Antony76/AllAboutNeowayM590/README.md

# All about Neoway GSM/GPRS modem M590/M590e

This repo started as a "bookmark" to me to bringup this M590 module

 Please start with the Wiki https://github.com/Antony76/AllAboutNeowayM590/wiki

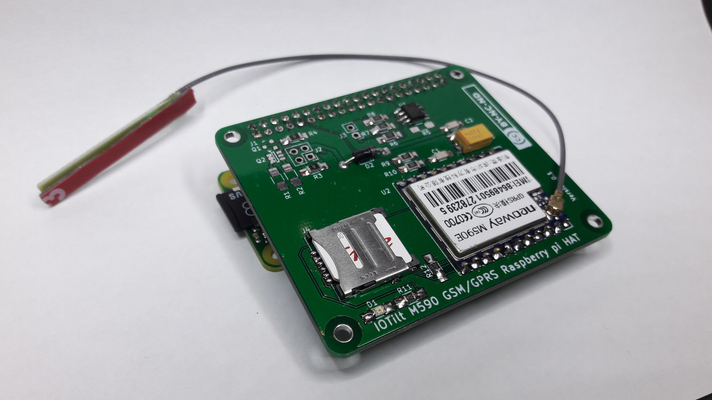
[picture p1: docs/Raspberry_piB+_HAT.jpg]
PCB
