Antony76/AllAboutNeowayM590/datasheet/M590_pinout.jpg

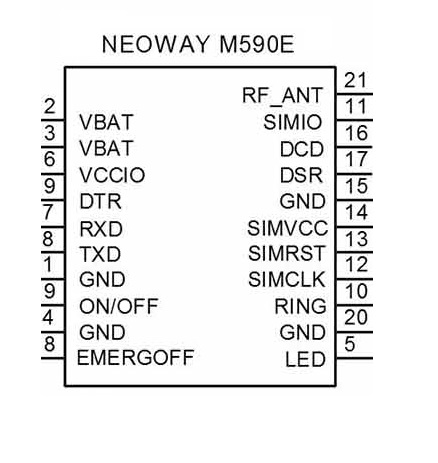
datasheet/M590_pinout.jpg
