Antony76/AllAboutNeowayM590/datasheet/MicroSIMSocket_bottom.jpg

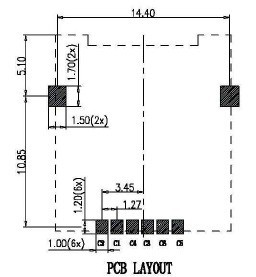
datasheet/MicroSIMSocket_bottom.jpg
