Antony76/AllAboutNeowayM590/datasheet/MicroSIMSocket_top.jpg

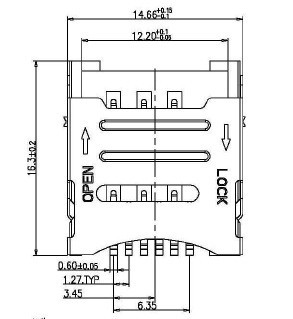
datasheet/MicroSIMSocket_top.jpg
