Antony76/AllAboutNeowayM590/docs/SIMpinout.png

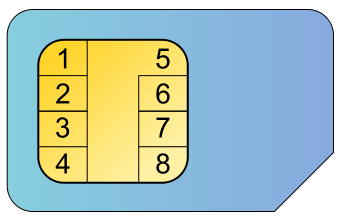
docs/SIMpinout.png
