Antony76/AllAboutNeowayM590/docs/usb-ttl1.jpg

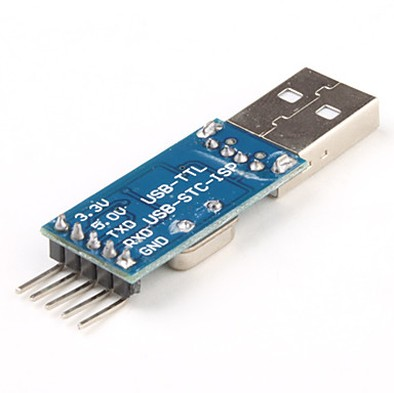
docs/usb-ttl1.jpg
