Antony76/AllAboutNeowayM590/docs/usb-ttl2.jpg

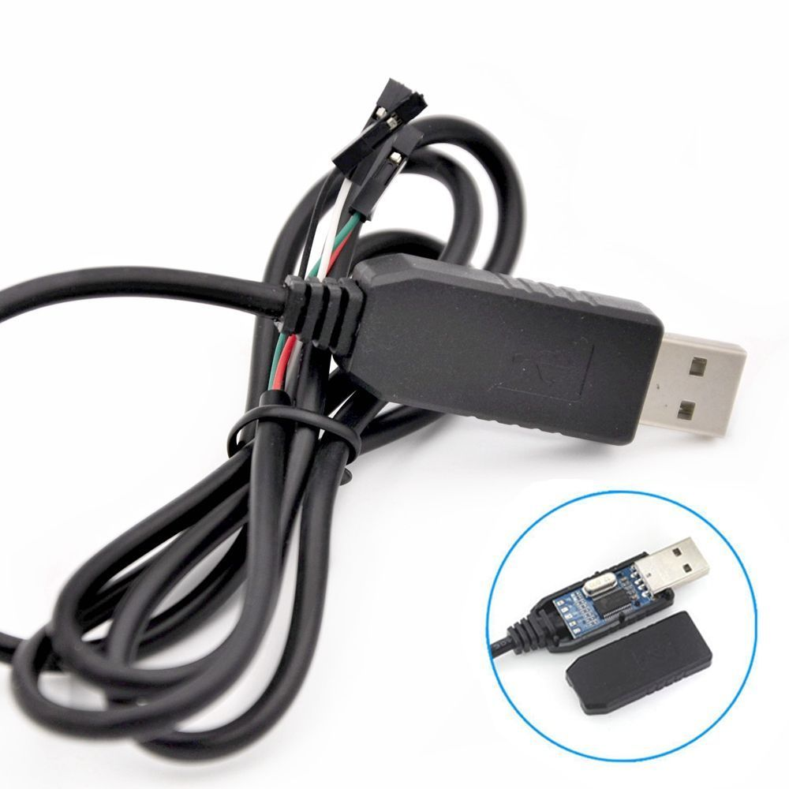
docs/usb-ttl2.jpg
