Antony76/AllAboutNeowayM590/PCB/Neoway_m590_diy_kit.jpg

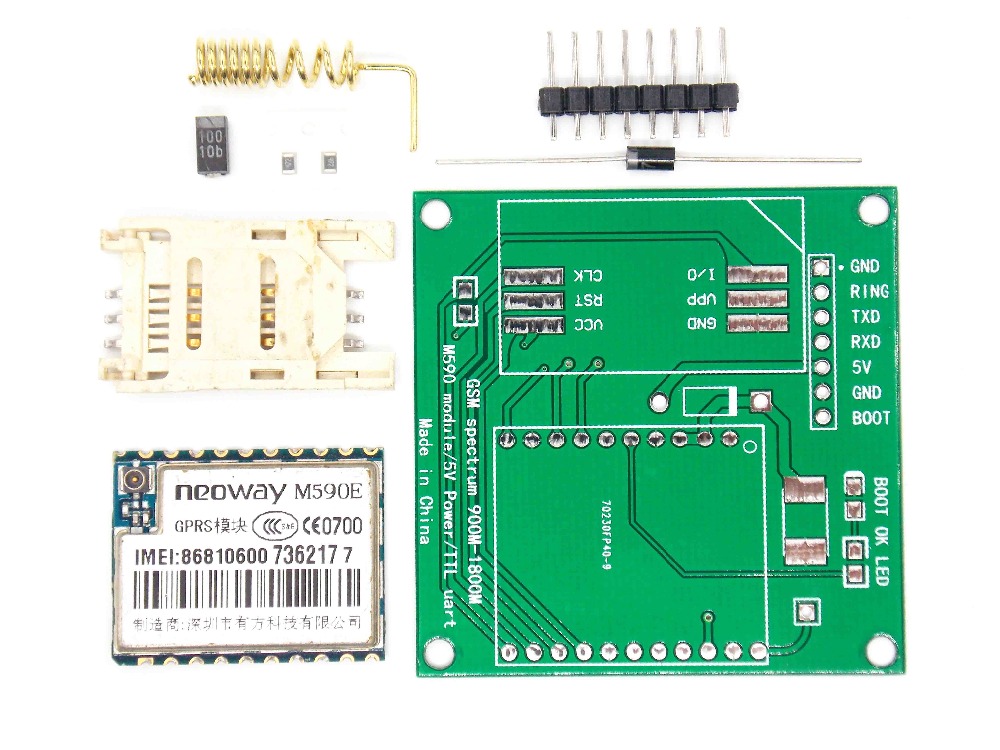
PCB/Neoway_m590_diy_kit.jpg
