Antony76/AllAboutNeowayM590/PCB/pcb_copper_side.jpg

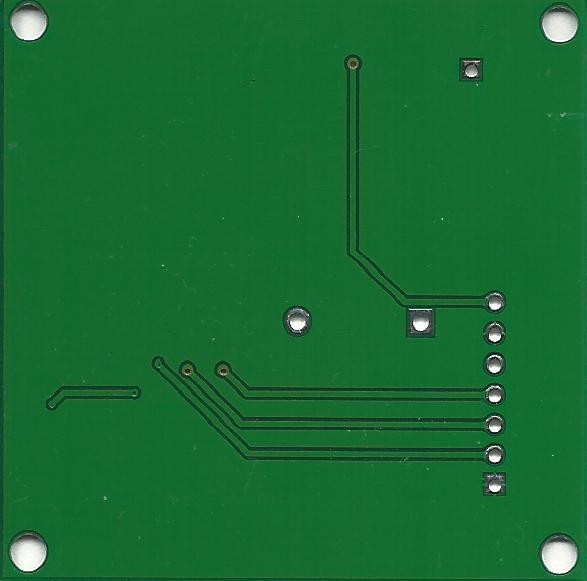
PCB/pcb_copper_side.jpg
