Antony76/AllAboutNeowayM590/PCB/pcb_top_side.jpg

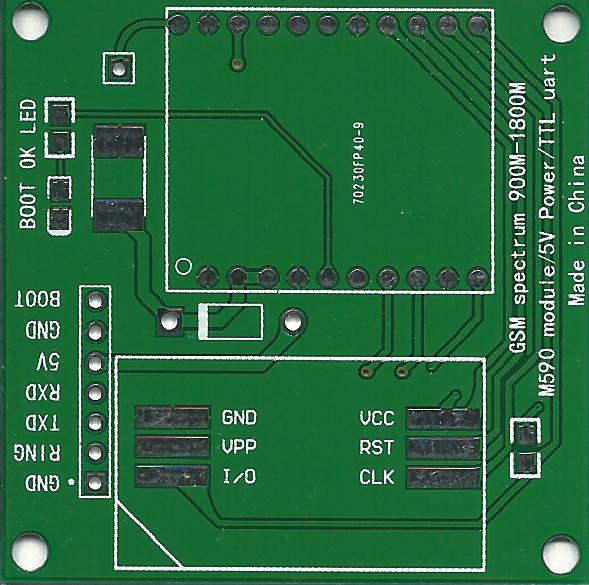
PCB/pcb_top_side.jpg
