Antony76/AllAboutNeowayM590/PCB/raspberrrypi_hat/meta/original_placement.png

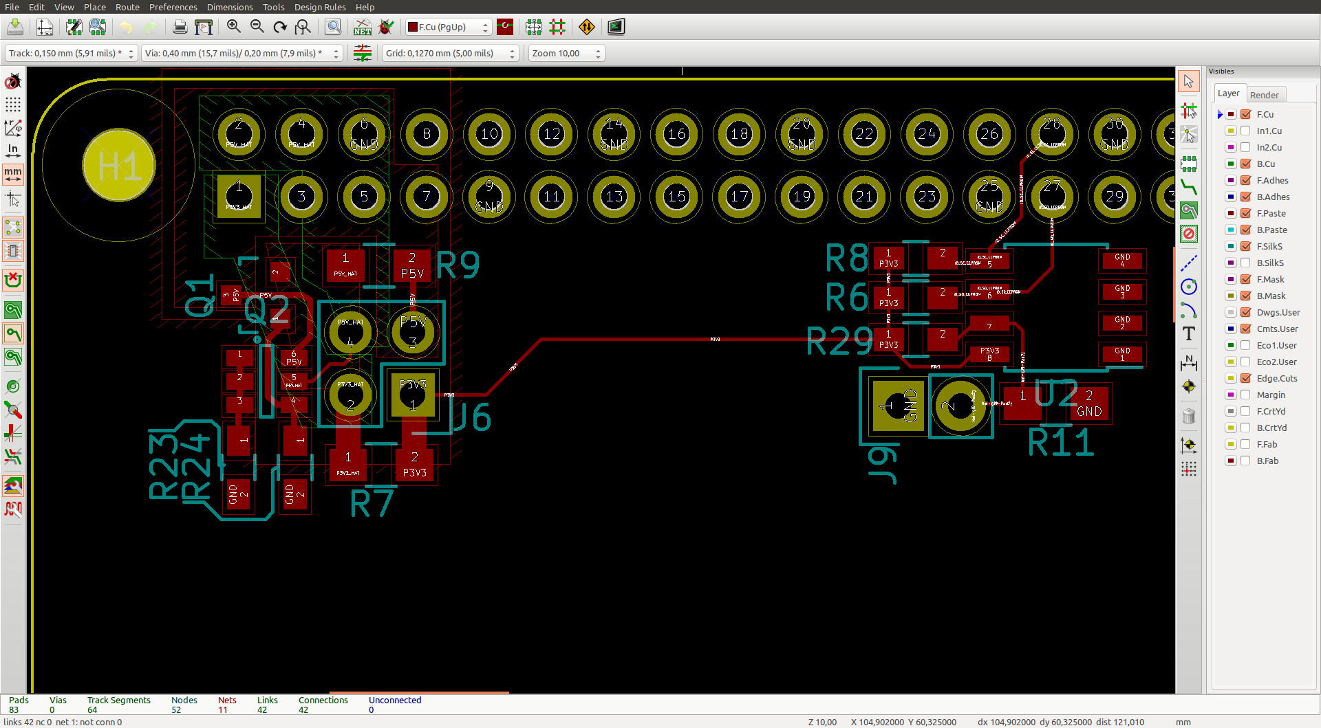
PCB/raspberrrypi_hat/meta/original_placement.png
