Antony76/AllAboutNeowayM590/PCB/raspberrrypi_hat/raspberrrypi_hat.kicad_pcb

## KiCad design PCB/raspberrrypi_hat/raspberrrypi_hat.kicad_pcb (2017-07-28)

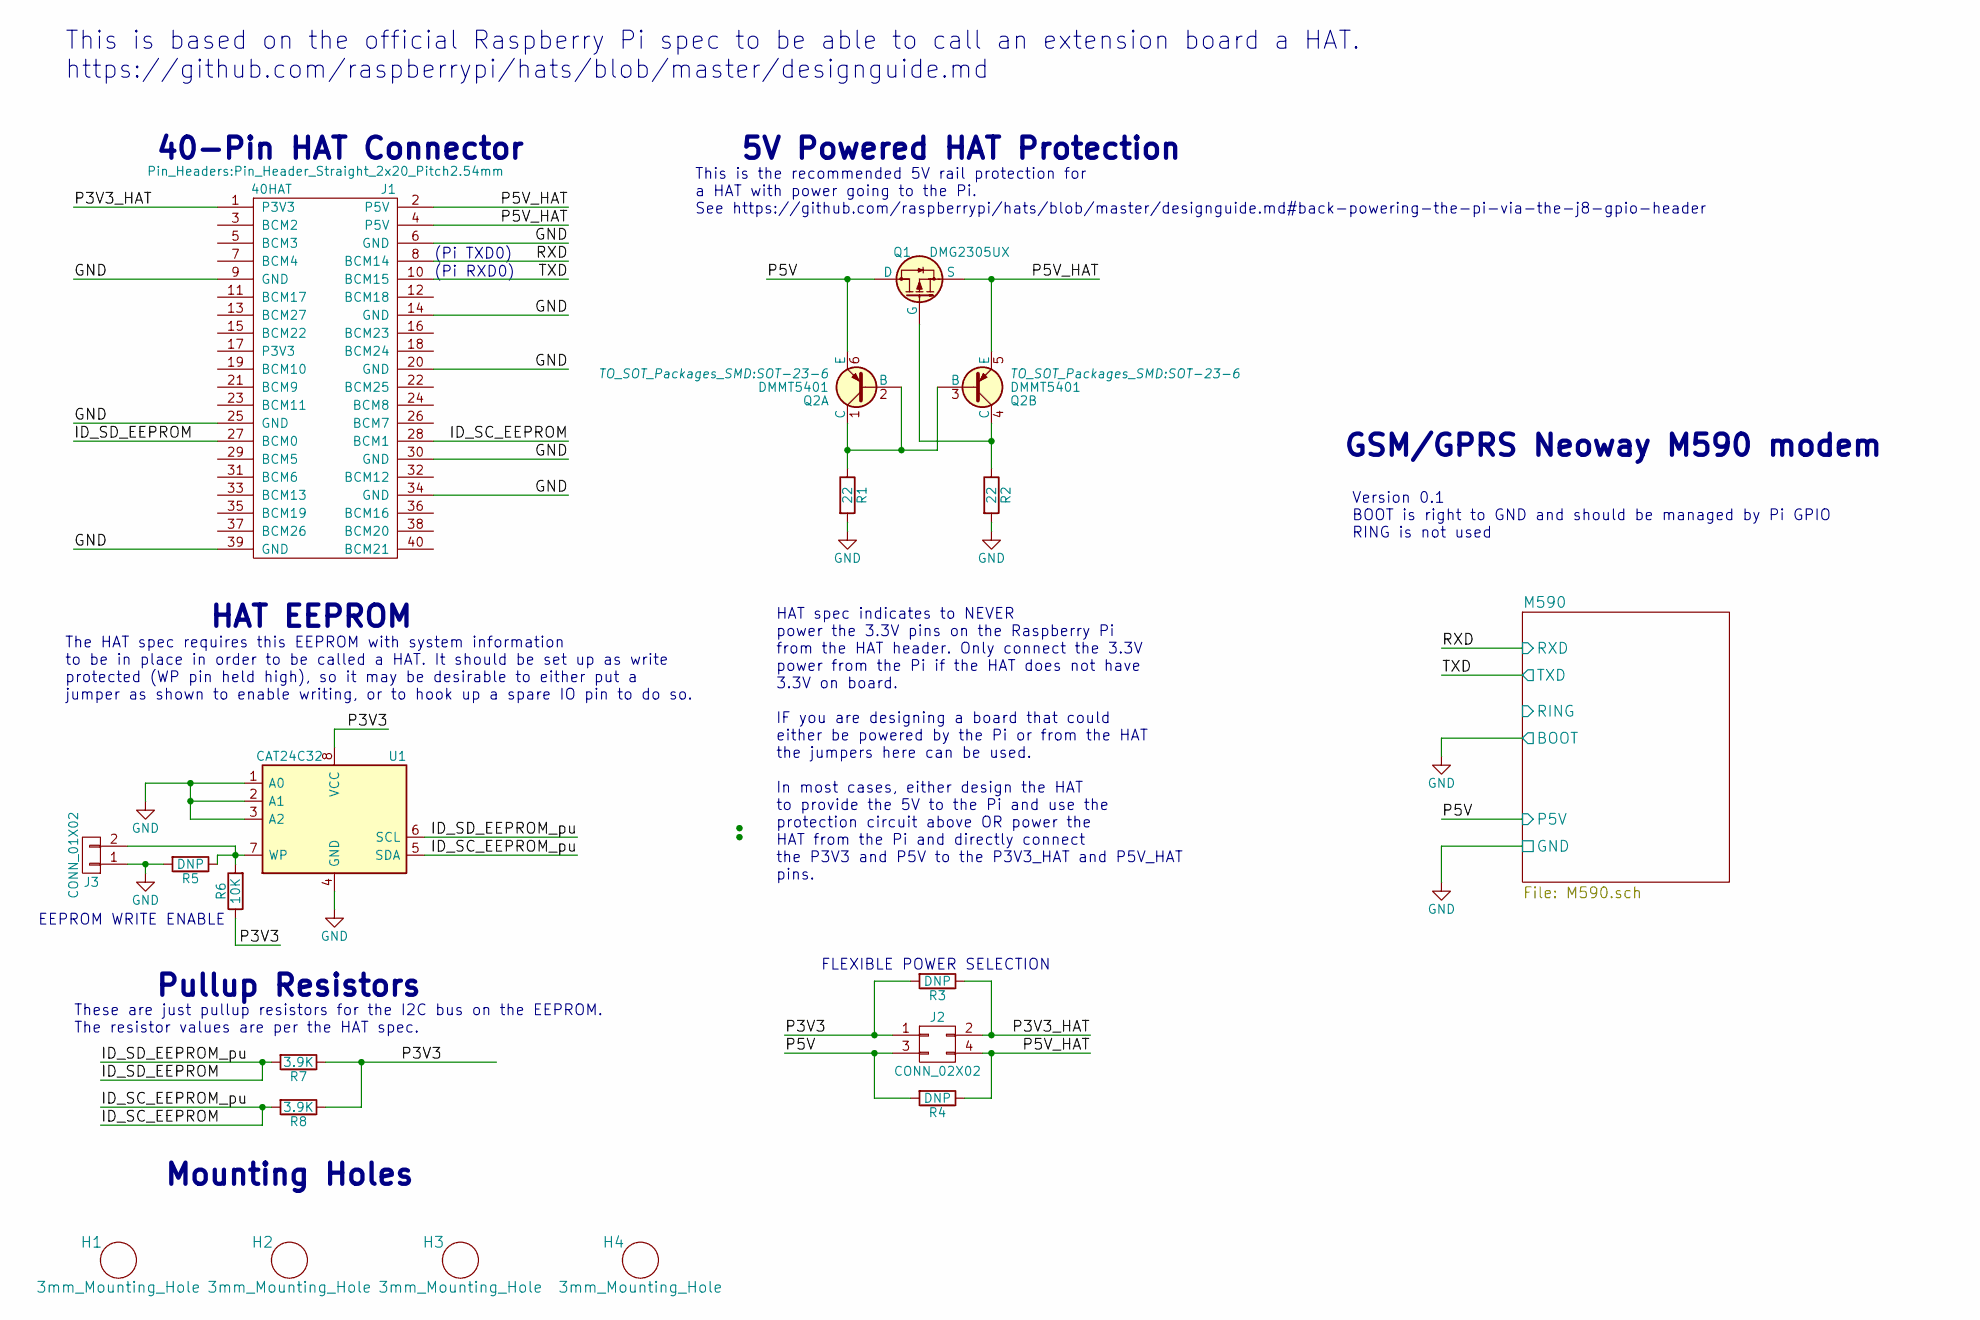
[picture p14: schematic raspberrrypi_hat.sch, IOTilt M590 GSM/GPRS Raspberry pi HAT]

Parts:
H1, H2, H3, H4: 3mm_Mounting_Hole; NPTH_3mm_ID
J1: 40HAT; Pin_Header_Straight_2x20_Pitch2.54mm
J2: CONN_02X02; Pin_Header_Straight_2x02_Pitch2.54mm
J3: CONN_01X02; Pin_Header_Straight_1x02_Pitch2.54mm
Q1: DMG2305UX; SOT-23
Q2: DMMT5401; SOT-23-6
R1, R2: 22; R_1206_HandSoldering; MPN RC0402JR-0722RL
R3, R4, R5: DNP; R_1206_HandSoldering; MPN RC0402JR-0722RL
R6: 10K; R_1206_HandSoldering; MPN RC0402JR-0722RL
R7, R8: 3.9K; R_1206_HandSoldering; MPN RC0402JR-0722RL
U1: CAT24C32; SOIC-8_3.9x4.9mm_Pitch1.27mm

Connections:
/ID_SC_EEPROM: J1.28 (BCM1), R8.2, U1.5 (SDA)
/ID_SD_EEPROM: J1.27 (BCM0), R7.2, U1.6 (SCL)
/P3V3: J2.1, R3.2, R6.1, R7.1, R8.1, U1.8 (VCC)
/P3V3_HAT: J1.1 (P3V3), J2.2, R3.1
/P5V: J2.3, Q1.3 (D), Q2.6 (E), R4.2; also elsewhere on the board
/P5V_HAT: J1.2 (P5V), J1.4 (P5V), J2.4, Q1.2 (S), Q2.5 (E), R4.1
/RXD: J1.8 (BCM14); also elsewhere on the board
/TXD: J1.10 (BCM15); also elsewhere on the board
GND: J1.6 (GND), J1.9 (GND), J1.14 (GND), J1.20 (GND), J1.25 (GND), J1.30 (GND), J1.34 (GND), J1.39 (GND), J3.1, R1.2, R2.2, R5.2, U1.1 (A0), U1.2 (A1), U1.3 (A2), U1.4 (GND); also elsewhere on the board
unnamed: J3.2, R5.1, R6.2, U1.7 (WP)
unnamed: Q1.1 (G), Q2.4 (C), R2.1
unnamed: Q2.1 (C), Q2.2 (B), Q2.3 (B), R1.1

Notes on the sheet:
FLEXIBLE POWER SELECTION
5V Powered HAT Protection
This is the recommended 5V rail protection for a HAT with power going to the Pi. See https://github.com/raspberrypi/hats/blob/master/designguide.md#back-powering-the-pi-via-the-j8-gpio-header
EEPROM WRITE ENABLE
Pullup Resistors
HAT EEPROM
Mounting Holes
40-Pin HAT Connector
HAT spec indicates to NEVER power the 3.3V pins on the Raspberry Pi from the HAT header. Only connect the 3.3V power from the Pi if the HAT does not have 3.3V on board. IF you are designing a board that could either be powered by the Pi or from the HAT the jumpers here can be used. In most cases, e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
The HAT spec requires this EEPROM with system information to be in place in order to be called a HAT. It should be set up as write protected (WP pin held high), so it may be desirable to either put a jumper as shown to enable writing, or to hook up a spare IO pin to do so.
These are just pullup resistors for the I2C bus on the EEPROM. The resistor values are per the HAT spec.
This is based on the official Raspberry Pi spec to be able to call an extension board a HAT. https://github.com/raspberrypi/hats/blob/master/designguide.md
(Pi TXD0)
(Pi RXD0)
GSM/GPRS Neoway M590 modem
Version 0.1 BOOT is right to GND and should be managed by Pi GPIO RING is not used

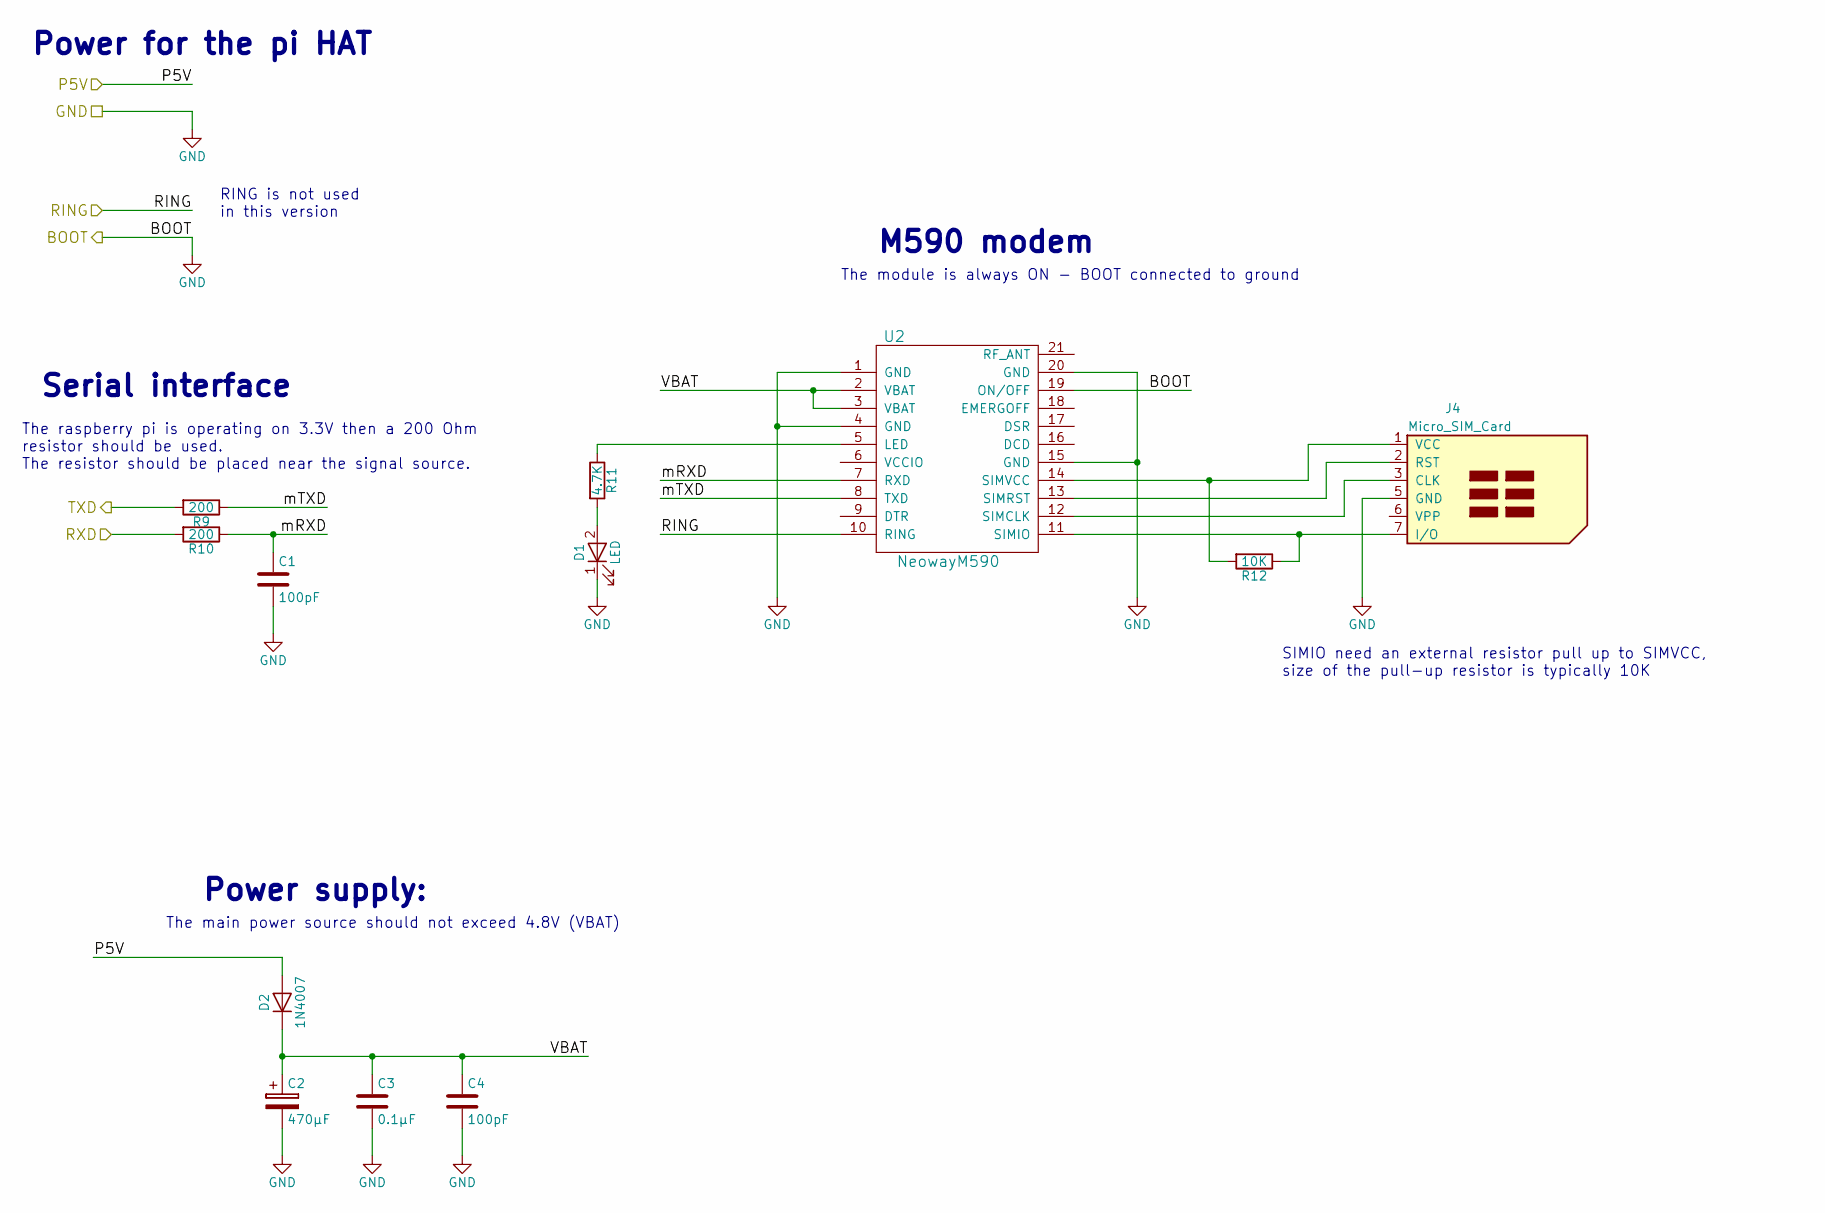
[picture p15: schematic M590.sch, IOTilt M590 GSM/GPRS Raspberry pi HAT]

Parts:
C1, C4: 100pF; C_1206_HandSoldering
C2: 470µF; C_1812_HandSoldering
C3: 0.1µF; C_1206_HandSoldering
D1: LED; LED_1206_HandSoldering
D2: 1N4007; D_T-1_P10.16mm_Horizontal
J4: Micro_SIM_Card; MicroSIMSocket
R9, R10: 200; R_1206_HandSoldering
R11: 4.7K; R_1206_HandSoldering
R12: 10K; R_1206_HandSoldering
U2: NeowayM590

Connections:
/M590/VBAT: C2.1, C3.1, C4.1, D2.1 (K), U2.2 (VBAT), U2.3 (VBAT)
/M590/mRXD: C1.1, R10.1, U2.7 (RXD)
/M590/mTXD: R9.1, U2.8 (TXD)
/P5V: D2.2 (A); also elsewhere on the board
/RXD: R10.2; also elsewhere on the board
/TXD: R9.2; also elsewhere on the board
GND: C1.2, C2.2, C3.2, C4.2, D1.1 (K), J4.5 (GND), U2.1 (GND), U2.4 (GND), U2.15 (GND), U2.19 (ON/OFF), U2.20 (GND); also elsewhere on the board
unnamed: D1.2 (A), R11.2
unnamed: J4.1 (VCC), R12.2, U2.14 (SIMVCC)
unnamed: J4.2 (RST), U2.13 (SIMRST)
unnamed: J4.3 (CLK), U2.12 (SIMCLK)
unnamed: J4.7 (I/O), R12.1, U2.11 (SIMIO)
unnamed: R11.1, U2.5 (LED)

Notes on the sheet:
The main power source should not exceed 4.8V (VBAT)
Power supply:
The module is always ON - BOOT connected to ground
M590 modem
The raspberry pi is operating on 3.3V then a 200 Ohm resistor should be used. The resistor should be placed near the signal source.
Serial interface
SIMIO need an external resistor pull up to SIMVCC, size of the pull-up resistor is typically 10K
RING is not used in this version
Power for the pi HAT

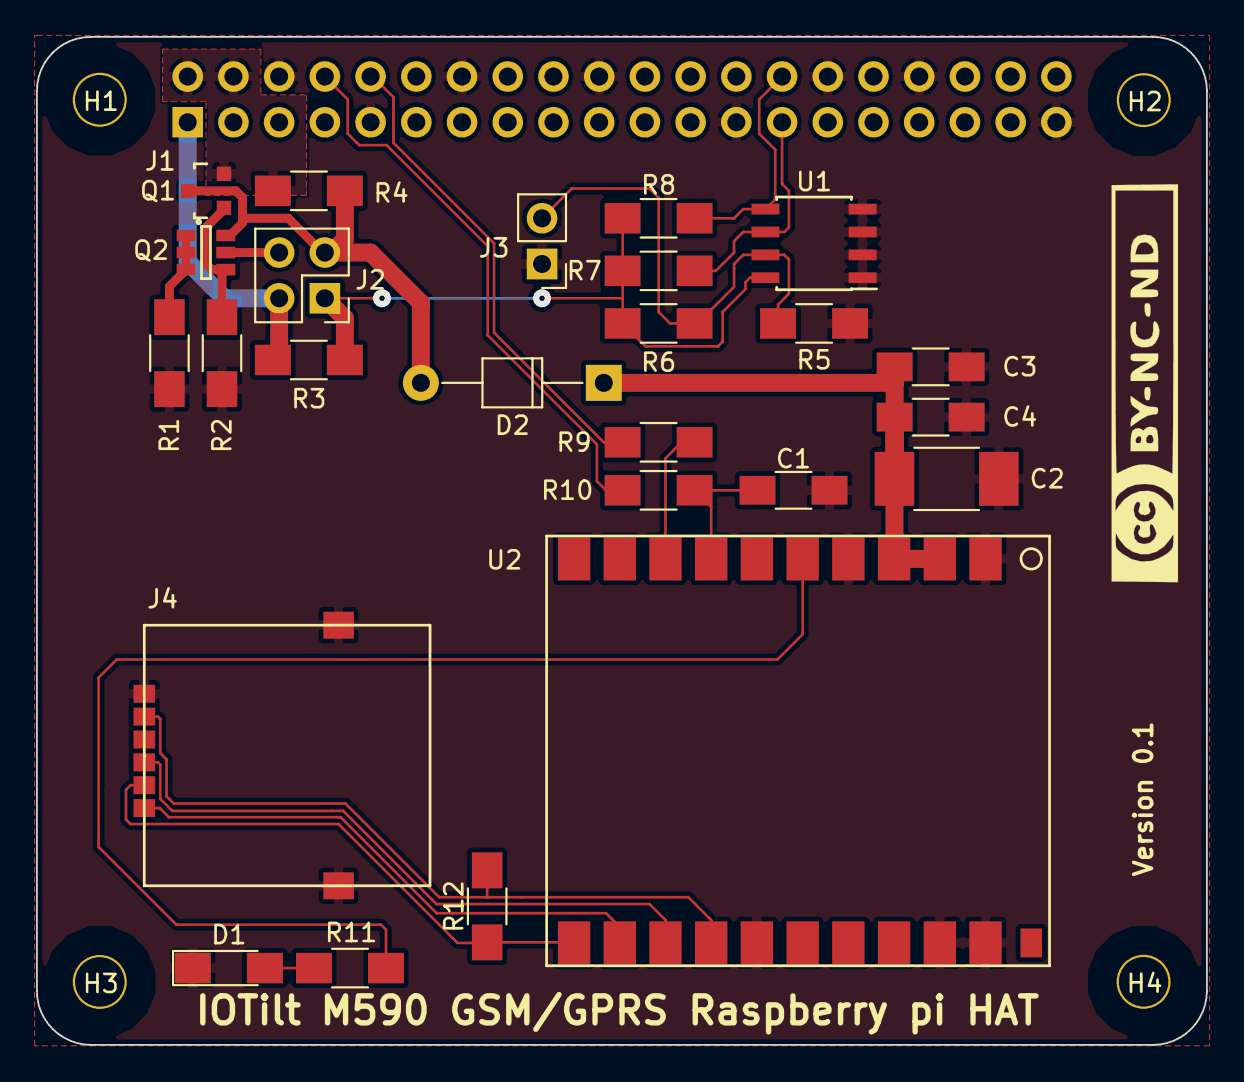
[picture p16: board raspberrrypi_hat.kicad_pcb from above]

Board: 4 copper layers, 65.0 x 56.0 mm, 30 parts (1 on the bottom side), 21 nets.
