Antony76/AllAboutNeowayM590/(threads)

Thread 3 (2017-07-25):

PCB: R11 to D1 connexion issue

Antony76, 2017-07-25:
Wiring issue between R11 and D1.
Fortunatly the track is connecting the components even if the net still not connected.

Antony76, 2017-07-28:
Fixed in a846b705

Closed 2017-07-28.

Thread 4 (2017-07-25):

PCB: Fix P5V_HAT filled zone in B.Cu layer

Antony76, 2017-07-25:
Keepout zone outline went wrong in B.Cu layer.
P5V_HAT short cut with GND

Antony76, 2017-07-25:
How to fix the PCB prototypes:
- Drill the 3 holes in B.Cu side. The 2 of the GPIO header and J2 pin 4.
- Ensure the short is sorted
- Solder a wire between GPIO header and J2

Thread 5 (2017-07-25):

SCH: Change R9/R10 to 220R

Antony76, 2017-07-25:
220R is easier to find in R E12 serie.
Must be double checked if the value is not too high.

Antony76, 2017-07-26:
First prototype issued with 220R then working properly.
I am going to update the SCH and close this ticket

Antony76, 2017-07-28:
Fixed in 797fd5577b5da0cf89ca74409df89e57b4796a34

Closed 2017-07-28.

Thread 6 (2017-07-28):

PCB: Simplify EEPROM supply

Antony76, 2017-07-28:
Supply EEPROM 3.3V from PI header pin 17 instead of pin 1. This should ease the PCB routing.

Thread 7 (2017-07-29):

SCH: Wrong GPIO header footprint

Antony76, 2017-07-29:
I have changed the raspberry pi 40 pins GPIO header in PCB but forgot to change it in the schematic and net file

Antony76, 2017-07-29:
Fixed in 2bc245e0b04e8032ee5e009614c2a311a0125e28

Closed 2017-07-29.

Thread 8 (2017-08-01):

PCB: Increase the size of C2 footprint

Antony76, 2017-08-01:
The size of the C3 footprint is a bit short for hand soldering. And more room too.

Thread 9 (2019-02-10):

M590 Dat Send Issue

vtomanov, 2019-02-10:
some time when I send data I get

+CME ERROR: 100

100 is unknown error :(

it really weird as some time it is after the OK sometime before etc.
any suggestion will be very appreciated.

EXAMPLE LOG 1

GPRS: COMMAND[ AT+TCPSETUP=1,109.169.26.34,5409 ] SIZE[ 33 ]
GPRS: RESPONSE[ OK ]
GPRS: RESPONSE[ +TCPSETUP:1,OK ]
GPRS: DATA PREPARED LEN[ 51 ]
GPRS: COMMAND[ AT+TCPSEND=1,51 ]
GPRS: RESPONSE[ > ]
GPRS: COMMAND[ ��⸮	] -<<< the actual data 51 bytes + \r
GPRS: RESPONSE[ OK ]
GPRS: RESPONSE[ +TCPSEND:1,51 ]
GPRS: RESPONSE[ +CME ERROR: 100 ]

EXAMPLE LOG 2

GPRS: COMMAND[ AT+TCPSETUP=1,109.169.26.34,5409 ] SIZE[ 33 ]
GPRS: RESPONSE[ OK ]
GPRS: RESPONSE[ +TCPSETUP:1,OK ]
GPRS: DATA PREPARED LEN[ 8 ]
GPRS: COMMAND[ AT+TCPSEND=1,8 ] SIZE[ 15 ]
GPRS: RESPONSE[ > ]
GPRS: COMMAND[ ��⸮	] << the actual data 8 bytes + \r
GPRS: RESPONSE[ +CME ERROR: 100 ]
