Antony76/AllAboutNeowayM590/(commit log)

2017-06-17 Add PCB copper and top view
2017-06-17 Soldering the DIY kit
2017-06-21 Raspberry Pi HAT template selected from jonbuford's
    [raspberrrypi_hat.kicad_pcb, raspberrrypi_hat.sch]
2017-06-26 Start to modify Pi_HAT template to add new sheet. Create new M590 component in the library
    [M590.sch, raspberrrypi_hat.sch]
2017-06-27 Change Pi HAT footprints to SMD 1206_HandSoldering
    [M590.sch, raspberrrypi_hat.kicad_pcb, raspberrrypi_hat.sch]
2017-06-27 Connect hierarchical sheets
    [M590.sch, raspberrrypi_hat.kicad_pcb, raspberrrypi_hat.sch]
2017-06-27 Create NeowayM590 footprint
    [M590.sch, raspberrrypi_hat.kicad_pcb]
2017-06-28 SCH: M590 and pi wirering
    [M590.sch, _saved_file594B14CF.sch, raspberrrypi_hat.sch]
2017-06-29 DS: add Micro SIM socket description to make footprint
2017-06-29 SCH: Change page size to A4, update footer and add comments about parts
    [M590.sch, raspberrrypi_hat.sch]
2017-07-03 Create Micro-SIM socket footprint
2017-07-03 PCB: Change RPi header + add Micro SIM socket. Starting placement
    [M590.sch, raspberrrypi_hat.kicad_pcb, raspberrrypi_hat.sch]
2017-07-03 Fix TX/RX serial resistor short-cut by adding mTX/mRX in M590 module sheet
    [M590.sch, raspberrrypi_hat.kicad_pcb]
2017-07-04 PCB: keep on routing
    [raspberrrypi_hat.kicad_pcb]
2017-07-05 PCB: routing completed. Reworked alim+eeprom. Add filled zones.
    [raspberrrypi_hat.kicad_pcb]
2017-07-06 PCB: update Micro SIM socket footprint. Move cmp references
    [raspberrrypi_hat.kicad_pcb]
2017-07-07 SCH: delete _saved* files
    [_saved_file594B14CF.sch]
2017-07-09 Mark the project with Creative Commons by-nc-nd license
    [M590.sch, raspberrrypi_hat.kicad_pcb, raspberrrypi_hat.sch]
2017-07-09 PCB: Add small CC-by-nc-nd license logo to PCB front side
    [raspberrrypi_hat.kicad_pcb]
2017-07-10 FTP: Fix MicroSimSocket F.Skill + move couple of refs
    [raspberrrypi_hat.kicad_pcb]
2017-07-10 PCB: Add description on F.Silks. IOTilt M590 GSM/GPRS Raspberry pi HAT
    [raspberrrypi_hat.kicad_pcb]
2017-07-10 SCH: update page title and add CC license on modem sheet
    [M590.sch, raspberrrypi_hat.sch]
2017-07-10 PCB: Add version 0.1 on F.Silks
    [raspberrrypi_hat.kicad_pcb]
2017-07-10 SCH: Fix page title herarchy
    [M590.sch]
2017-07-10 SCH: Fix txt placement about EEPROM WRITE ENABLE
    [raspberrrypi_hat.sch]
2017-07-16 PCB: move components Refs
    [raspberrrypi_hat.kicad_pcb]
2017-07-17 Change LED footprint to 1206 HandSoldering
    [M590.sch, raspberrrypi_hat.kicad_pcb]
2017-07-18 PCB: change via size/diam to 1mm/0.3mm regarding prod requierements
    [raspberrrypi_hat.kicad_pcb]
2017-07-28 Fix #3 R11 to D1 connexion issue
    [raspberrrypi_hat.kicad_pcb]
2017-07-28 Fix #5 Change R9/R10 to 220R
    [M590.sch]
2017-07-29 Fix #7 Wrong GPIO header footprint
    [raspberrrypi_hat.sch]
2017-10-18 Add first photo of the PCB raspberry pi HAT rev B+
2017-10-18 Add PCB's photo in the front page
